Jaxal83/parkingSensor/Spring 2020/Hardware Design/Park-It-CDA fritzing.JPG

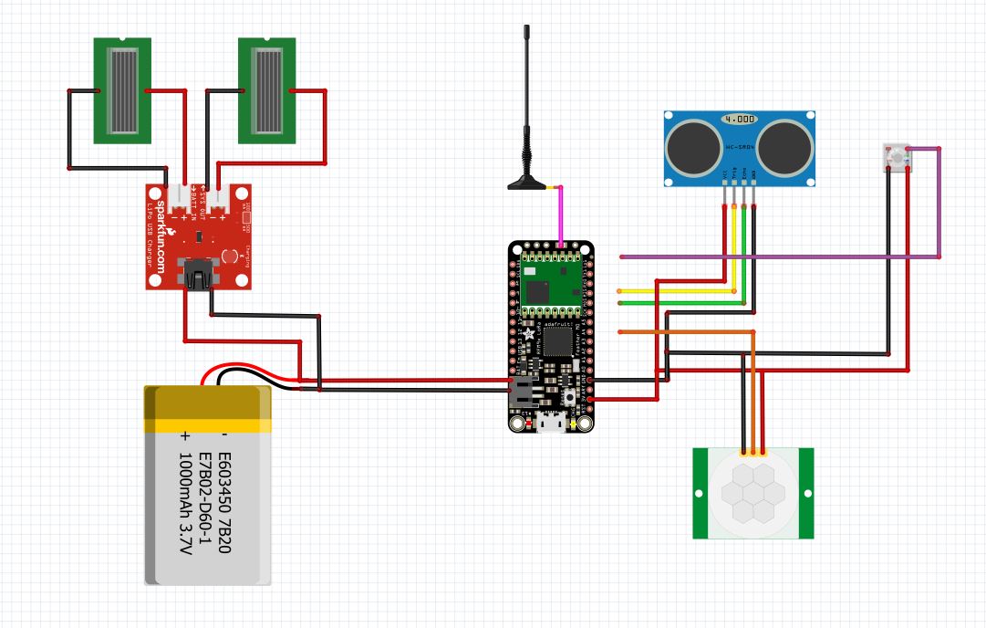
Spring 2020/Hardware Design/Park-It-CDA fritzing.JPG
