Jaxal83/parkingSensor/Spring 2020/Hardware Design/projects_batt_solar.jpg

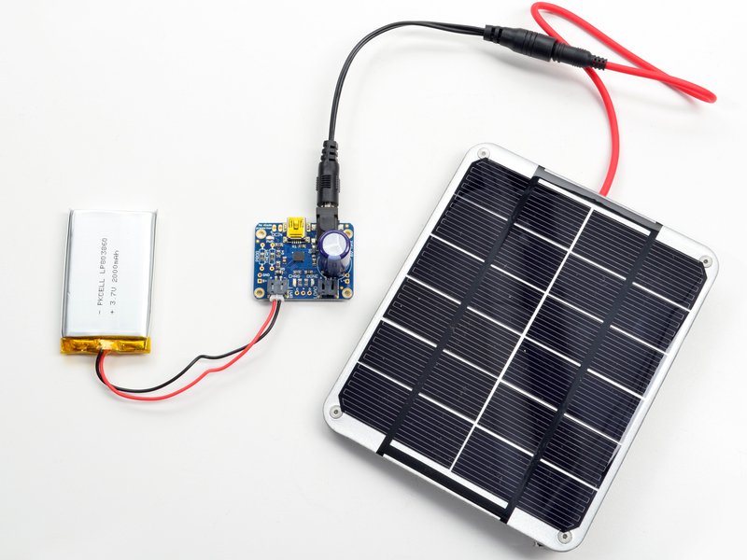
Spring 2020/Hardware Design/projects_batt_solar.jpg
