Jaxal83/parkingSensor/Spring 2020/Project Status Report 2-19.docx

# Project Status Report

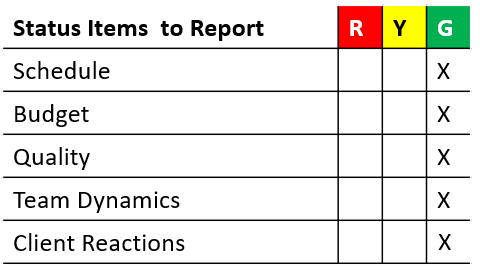
[picture p15: figure]

# Nikolai

Get the mesh network communication working on the Adafruit Feathers without requiring EEPROM.

First step was to find out how to obtain a unique identifier on the Feather M0’s.

There was the possibility of a MAC address on the Radio, LoRa serial number or the SAMD21 processor having an ID. Found a library that can extract this value and display it on serial output.

From here I hard coded the first byte in the radio sending test and assigned an ID of 1 or 2 to the two Feathers that I have for simplicity. Once the others come in, they will be assigned 3 – 7.

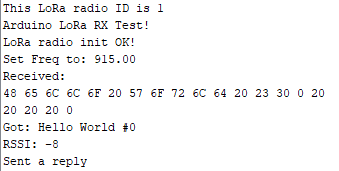
[picture p16: figure]
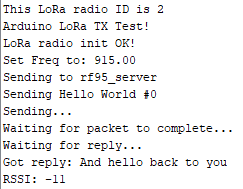
[picture p17: figure]

Next step is to have the Feathers go to sleep and then wake up on a timer to send a message.

This will be more difficult to debug since the serial port to the monitor gets disabled upon sleep and doesn’t get reestablished upon waking. I plan to use the built in LED to blink a number of times depending on whether it is sending or has received a message.

# Tyrel

# Zane

# Joel
