Jaxal83/parkingSensor/Client Meetings/Client meeting 4-9-20.docx

Date: 4/9/20

Start Time: 3:30 pm

End Time: 4:45 pm

Present: Nikolai, Zane, Joel, Dr Shovic, Tyrel, Dr Sheldon

Location: Innovation Den

Agenda: Follow up on the design report and changes to the project

Outcomes: John is going to provide 2 Yagi antennas for us to use

To Do: Zane and Nikolai are going to test out the antennas and see how far we get
