Jaxal83/parkingSensor/Team Meetings/3-23-20.docx

Date: 3/23/20

Start Time: 2:40 pm

End Time: 2:50 pm

Present: Nikolai, Tyrel

Location: Tyrel’s House

Agenda: Tyrel received the gateway but couldn’t turn it on. Asked in Discord whether any of us has a 12V 1 A power supply. Nikolai does and went to give it to him.

Outcomes: The power supply worked.

To Do: Tyrel is working on getting the broken power supply RMA’ed
