Jaxal83/parkingSensor/Team Meetings/3-6-20.docx

Date: 3/6/20

Start Time: 12:15 pm

End Time: 12:30 pm

Present: Nikolai, Joel

Location: Discord

Agenda: Joel reappeared

Outcomes: Have instructed Joel on what he will be doing. Nikolai will give him 2 Arduino Uno’s with LoRa radios attached. Joel will then need to use the send/receive program and update it to encrypt the messages sent between the units.

To Do: Joel – install Arduino IDE
