Jaxal83/parkingSensor/Team Meetings/4-16-20.docx

Date: 4/16/20

Start Time: 3:30 pm

End Time: 4:45 pm

Present: Nikolai, Tyrel, Zane, Joel, Dr Sheldon

Location: Zoom

Agenda: Update on what we’ve been doing.

Outcomes: Zane and Nikolai have been having difficulty with getting the range required on the antennas.

Joel needs to fix the encryption program.

Tyrel is going to give Nikolai the Dragino gateway and set it up to reach his MQTT server over the internet.

To Do: Email John to see what we can do about
