Jaxal83/parkingSensor/Team Meetings/4-23-20.docx

Date: 4/23/20

Start Time: 3:30 pm

End Time: 4:45 pm

Present: Nikolai, Tyrel, Zane, Joel, Dr Sheldon

Location: Zoom

Agenda: Final preparations before the expo

Outcomes: We need to come up with a plan B if we can’t get the range on the antennas working. Either Nikolai’s and Zane’s driveway will be the location of the demo.

To Do: Spend all weekend trying to get the antennas working

Prepare the Powerpoint presentation and present it next week in some practice runs with everyone
