Jaxal83/parkingSensor/Team Meetings/4-30-20.docx

Date: 4/30/20

Start Time: 11:30 am

End Time: 9:00 pm

Present: Nikolai, Tyrel, Zane, Joel, Dr Sheldon

Location: Zoom, Discord

Agenda: Combination of multiple meetings today. Continued refining and practicing the presentation. Presented to Dr Sheldon again at 3:30pm

Outcomes: We are getting better on timing and reducing it. 16:20 for first practice, 12:40 for second, 13:06 for third.

To Do: Tyrel and Zane are recording new demo videos to put in
