Jaxal83/parkingSensor/Fall 2019/meeting 9-24-19.docx

What lora chip will we use if any

What platform – Arduino uno, nano? All in one

Need to research this and get them ordered – try for thursday.

We’ll all need about 3-5 each for testing individually.

Sound

Atmega 32u4
