Jaxal83/parkingSensor/Fall 2019/9mo calendar.docx

| 9-Month timeline

By: Nikolai Tiong, Tyrel Parker, Zane Goodrick

Tasks | | -Design -Prototype -Testing -Network -Reporting -Data -Simulation | | Goal | | Finalized design by Mid October | | Jobs | | Nikolai- Tyrel- Zane-
2019 Sep | | Research and design proposals | | 2019 Oct | | Testing and building | | 2019 Nov | | Testing and building of final design
2019 Dec | | Finishing prototype | | 2020 Jan | | Building deployable units | | 2020 Feb | | Deploy units for data collection
2020 Mar | | Implement data into simulation | | 2020 Apr | | Finalizing expo marketing items | | 2020 May | | Expo
