Jaxal83/parkingSensor/Team Meetings/2-11-20.docx

Date: 2/11/20

Start Time: 3:30 pm

End Time: 4:45 pm

Present: Nikolai, Tyrel, Joel, Dr Sheldon, Dr Rinker

Location: Innovation Den

Agenda: Joel will give his presentation on the Wiki page and his progress so far.

Outcomes: The wiki still needs more work on it.

Joel needs to contact Dr Shovic on his own time to find out about the VNC requirements

To Do: Joel Keeps working on the wiki.

Keep working on the project
