Jaxal83/parkingSensor/Fall 2019/capstone use case.jpg

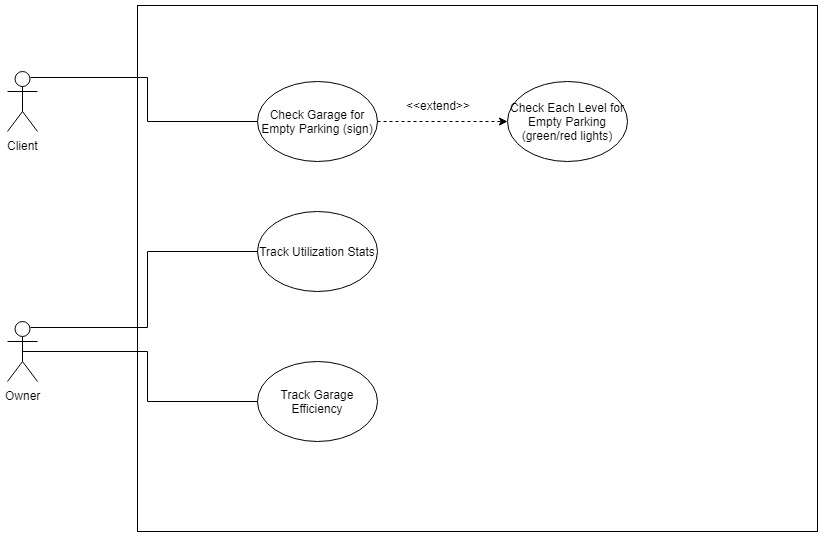
Fall 2019/capstone use case.jpg
