Jaxal83/parkingSensor/Spring 2020/database.png

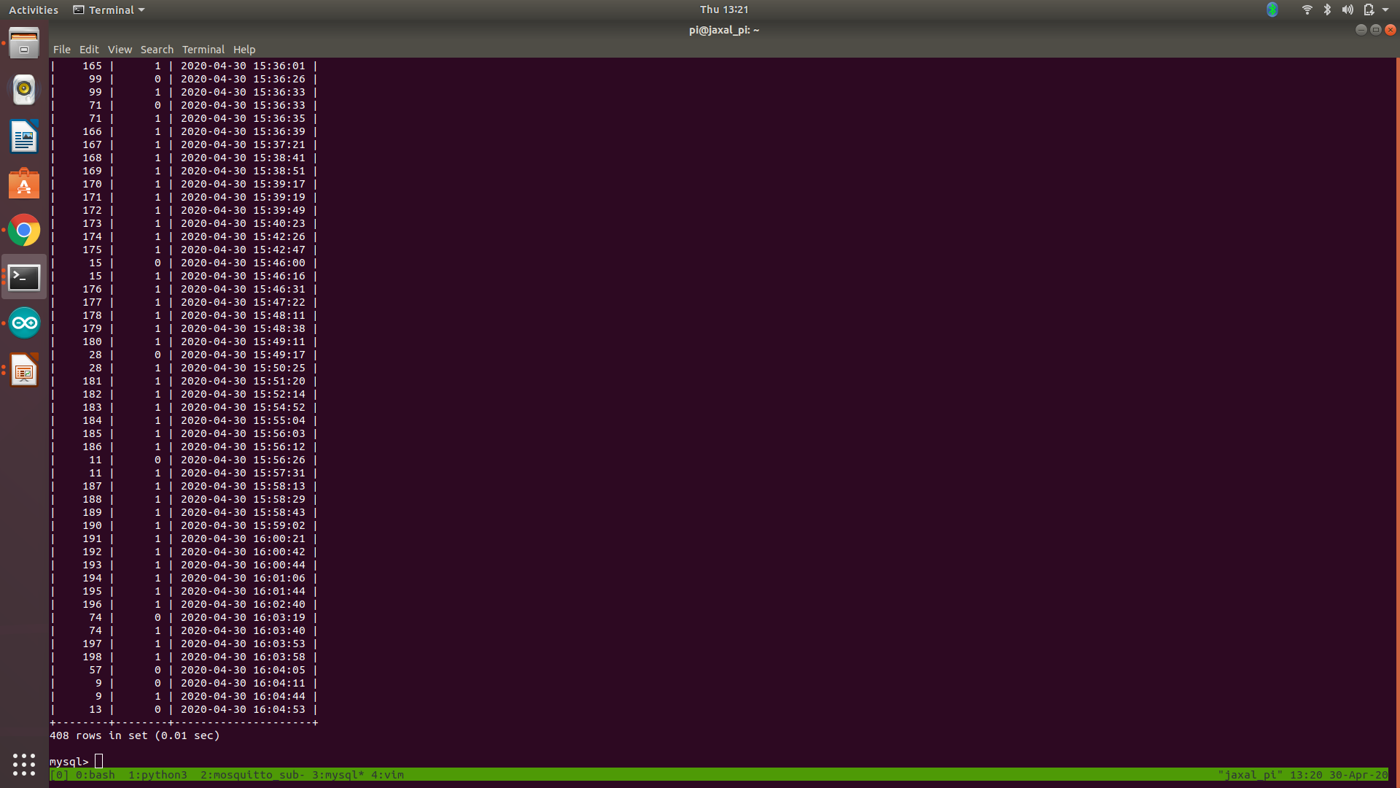
Spring 2020/database.png
