Jaxal83/parkingSensor/Spring 2020/google map of garage.png

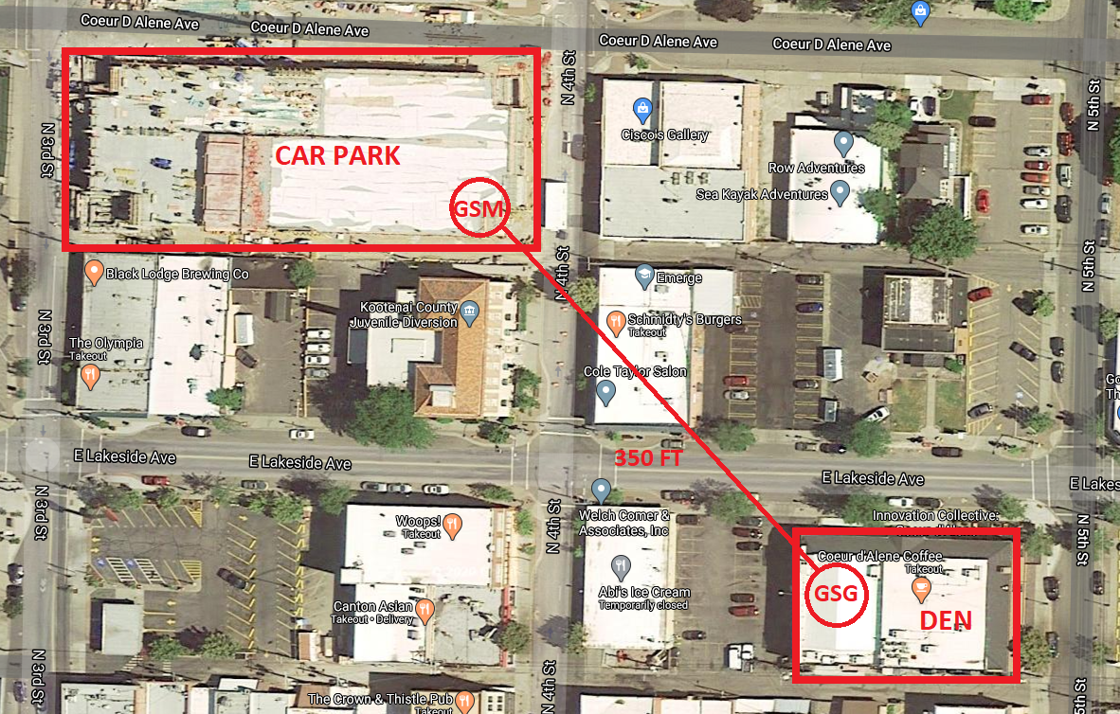
Spring 2020/google map of garage.png
