Jaxal83/parkingSensor/Spring 2020/Hardware Design/example solar arduino schematic.png

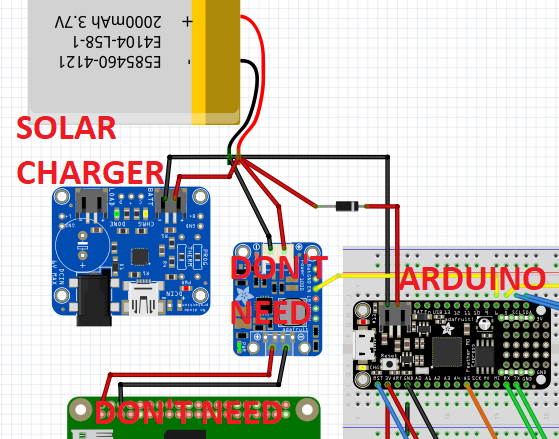
Spring 2020/Hardware Design/example solar arduino schematic.png
