Jaxal83/parkingSensor/Spring 2020/Hardware Design/final model front.PNG

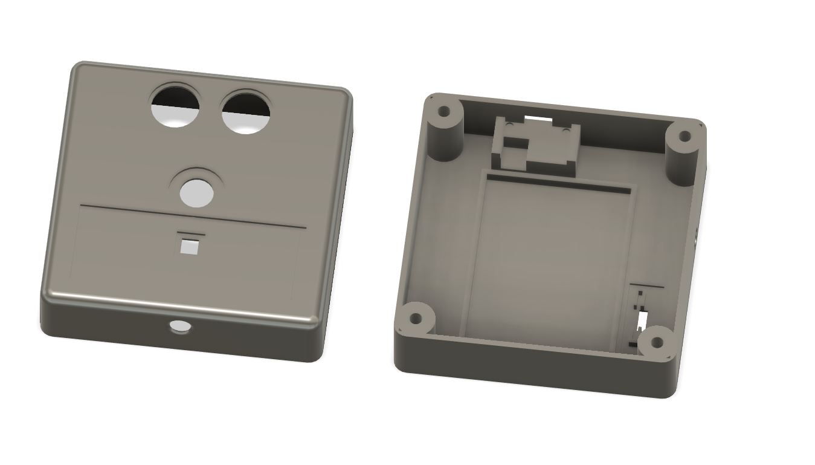
Spring 2020/Hardware Design/final model front.PNG
