Jaxal83/parkingSensor/Spring 2020/Hardware Design/Final Model.PNG

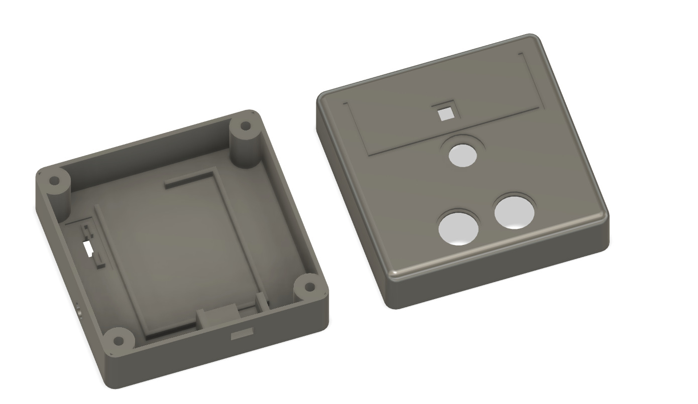
Spring 2020/Hardware Design/Final Model.PNG
