Jaxal83/parkingSensor/Spring 2020/Hardware Design/rough sketch.jpg

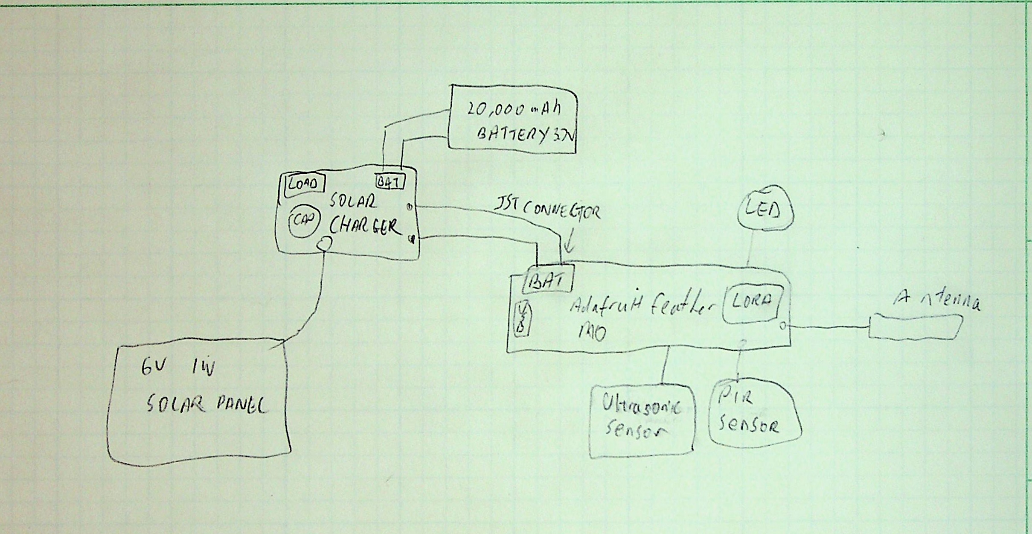
Spring 2020/Hardware Design/rough sketch.jpg
