Jaxal83/parkingSensor/Spring 2020/Possible Battery Purchases.xlsx

Item | Quantity | Price | Total | Notes | Link
Adafruit Feather M0 LoRa | 5 | $34.95 | $174.75 | The Arduino we will be using | https://www.adafruit.com/product/3178
6V 1W Solar Panel | 5 | $19.95 | $99.75 | For Charging the Battery | https://www.adafruit.com/product/3809
Solar Charger | 5 | $17.50 | $87.50 | For Charging the Battery | https://www.adafruit.com/product/390
3.8 mm/1.3mm to 5.5/2.1 cable | 5 | $1.50 | $7.50 | Connects Solar Panel to Solar Charger | https://www.adafruit.com/product/2788
DS3231 RTC | 5 | $13.95 | $69.75 | Clock Module to keep Arduinos in Sync | https://www.adafruit.com/product/3013
3.6V 20.1Ah Li ION Battery | 5 | $92.15 | $460.75 |  | https://www.batteryspace.com/li-ion-18650-battery-3-6v-20-1ah-72-36wh-7a-rate-6s-s-ncr18650b---un38-3-passed.aspx
LoRa Gateway | 1
 |  |  | $900.00
