Jaxal83/parkingSensor/Spring 2020/Master_Gantt.ods

Sheet: Gantt
 | predicted time(hrs) | time spent(hrs) |  | 08/26/19 |  |  |  |  |  |  | 10/14/19 |  |  |  |  |  |  |  | 12/09/19 |  |  |  | 01/06/20 |  |  |  |  |  |  | 02/24/20 |  |  |  |  |  |  |  |  | 05/01/20
Nikolai |  |  | weeks | 1 | 2 | 3 | 4 | 5 | 6 | 7 | 8 | 9 | 10 | 11 | 12 | 13 | 14 | 15 | 16 | 17 | 18 | 19 | 20 | 21 | 22 | 23 | 24 | 25 | 26 | 27 | 28 | 29 | 30 | 31 | 32 | 33 | 34 | 35 | 36 | 37 | 38 | 39 | 40 | 41 | 42 | 43 | 44 | 45
research and purchase dev board | 5 | 20
test range | 10 | 60
design and develop mesh network | 30 | 60
implement security | 10 | 0
testing | 15 | 10
peer review | 10 | 4
documentation | 10 | 150
totals | 90 | 304
Tyrel
research simulation products | 10 | 35
determine needed data | 2 | 2
design transmission payload | 5 | 5
design and implement database | 5 | 5
design simulation environment | 15 | 95
implement data into simulation | 10 | 15
testing | 15 | 15
peer review | 10 | 10
documentation | 10 | 60
totals | 82 | 242
Zane
research and purchase sensor options | 5 | 20
test sensor options | 10 | 28
calculate power usage | 5 | 2
research and purchase power solution | 2 | 1
design and build case | 20 | 77
installation | 2 | 5
testing | 15 | 26
peer review | 10 | 2
documentation | 10 | 80
totals | 79 | 241
Joel
wiki | 15 | 30
encryption | 15 | 30
testing | 10 | 15
documentation | 10 | 8
totals | 50 | 83
group totals (hrs) | 301 | 870
group totals ($) | $30,100.00 | $87,000.00
 | planned
 | current
 | completed
 | late

Sheet: Gantt_2
 | 08/26/19 |  |  |  |  |  |  | 10/14/19 |  |  |  |  |  |  |  | 12/09/19 |  |  |  | 01/06/20 |  |  |  |  |  |  | 02/24/20 |  |  |  |  |  |  |  |  | 05/01/20
 | 1 | 2 | 3 | 4 | 5 | 6 | 7 | 8 | 9 | 10 | 11 | 12 | 13 | 14 | 15 | 16 | 17 | 18 | 19 | 20 | 21 | 22 | 23 | 24 | 25 | 26 | 27 | 28 | 29 | 30 | 31 | 32 | 33 | 34 | 35 | 36
Documentation
Research and purchase products
Test LoRa range
Determine needed data
Test sensors
Calculate power usage, research and purchase power solution
Design and develop mesh network, simulation environment, and units
Installation
Testing
Prepare for expo
Wiki
Encryption

Sheet: Management_Summary
 | Total |  |  | Coding |  |  | Meetings |  |  | Systems Analysis
 | Budgeted | Actual | Deficit | Budgeted | Actual | Deficit | Budgeted | Actual | Deficit | Budgeted | Actual | Deficit
Nikolai | $11,700.00 | $31,400.00 | ($19,700.00) | $9,000.00 | $30,400.00 | ($21,400.00) | $1,000.00 | $1,000.00 | $0.00 | $1,700.00 | $0.00 | $1,700.00
Tyrel | $10,800.00 | $25,100.00 | ($14,300.00) | $8,200.00 | $24,200.00 | ($16,000.00) | $1,000.00 | $900.00 | $100.00 | $1,600.00 | $0.00 | $1,600.00
Zane | $10,500.00 | $25,100.00 | ($14,600.00) | $7,900.00 | $24,100.00 | ($16,200.00) | $1,000.00 | $1,000.00 | $0.00 | $1,600.00 | $0.00 | $1,600.00
Joel | $5,500.00 | $11,200.00 | ($5,700.00) | $5,000.00 | $8,300.00 | ($3,300.00) | $500.00 | $2,900.00 | ($2,400.00)
Total | $33,000.00 | $81,600.00 | ($48,600.00) | $25,100.00 | $78,700.00 | ($53,600.00) | $3,000.00 | $2,900.00 | $100.00 | $4,900.00 | $0.00 | $4,900.00

Sheet: Meetings
 | Date | Aug 29 | Sep 05 | Sep 12 | Sep 19 | Oct 03 | Oct 10 | Oct 17 | Oct 24 | Nov 05 | Nov 12 | Nov 21 | Nov 28 | Dec 05 | Dec 12
 | Purpose | Team Meeting | First Customer Meeting | Team Meeting | Second Customer Meeting | Team Meeting | Team Meeting | Team Meeting | Teem Meeting | PDR | Team Meeting
 | Hours | 1 | 1 | 1 | 1 | 1 | 1 | 1 | 1 | 1 | 1 | 1 | 1 | 1 | 1
Nikolai | 10 | ü | ü | ü | ü | ü | ü | ü | ü | ü | ü
Tyrel | 9 | ü | ü | ü | ü | ü | ü | ü | ü |  | ü
Zane | 10 | ü | ü | ü | ü | ü | ü | ü | ü | ü | ü
Joel
Total | 29 | 3 | 3 | 3 | 3 | 3 | 3 | 3 | 3 | 2 | 3 | 0 | 0 | 0 | 0
ü

Sheet: SA
 | Task | Predicted(hrs) | spent(hrs) | 1 | 2 | 3 | 4 | 5 | 6 | 7 | 8 | 9 | 10 | 11 | 12 | 13 | 14 | 15
Nikolai | Technical Specs | 5
 | Meeting Notes | 5
 | SRS | 5
 | SRS2 | 2
 | Subtotal | 17 | 0
Tyrel | Gantt | 5
 | Budget | 5
 | PDR | 3
 | PDR2 | 1
 | CDR2 | 1
 | Updated Budget and Gantt | 1
 | Subtotal | 16 | 0
Zane | Diagrams | 4
 | Contract | 2
 | Project Plan | 4
 | PDR Diagrams | 2
 | Concept Art | 3
 | Updated Project Plan | 1
 | Subtotal | 16 | 0
 | Total | 49 | 0

Sheet: Budget
Item | Description | QTY | Est Price | Est Totals | *Blue Font indicates an estimated price due to additional research needed on that product. -Figuring 7 sets of sensors.
Boards | Arduino Pro Mini 328 | 10 | 9.45 | $94.50
LORA | Adafruit RFM95W LoRa Radio Transceiver | 10 | 17.96 | $179.60
Headers | Female and Male Header Bundle | 1 | 30 | $30.00
Antenna | 900 Mhz Antenna Kit for LoRa w/connector | 10 | 13.5 | $135.00
3D Printing Materials | White 3D printer filament | 3 | 19.99 | $59.97
Batteries | TBD | 7 | 20 | $140.00
Sensors | TBD | 7 | 20 | $140.00
Den Receiver | TBD | 1 | 100 | $100.00
Adhesive/ Mounting | TBD | 5 | 10 | $50.00
Paint | TBD | 3 | 5 | $15.00
 |  |  | Subtotal | $944.07
 |  |  | Goal | $1,500.00
 |  |  | Difference | $555.93
Item | Actual Description | QTY | Actual Price | Actual Totals
Boards | Arduino MKR 1310 | 2 | 42 | $84.00
LORA | Adafruit RFM95W LoRa Radio Transceiver | 3 | 19 | $57.00
Boards | Adafruit Feather M0 with LoRa | 5 | 34.95 | $174.75
Antenna | 4 PCS 915 Mhz LoRa Antenna | 2 | 10.99 | $21.98
Antenna connector | 10 PCS pack | 1 | 6.49 | $6.49
3D Printing Materials | Overture PLA Filament | 2 | 26.99 | $53.98
Batteries | 3.7v 2500mAh Rechargeable Lipo Battery | 5 | 15.09 | $75.45
Sensors | 5pcs Ultrasonic Distance Sensor | 1 | 14.13 | $14.13
Sensors | 5pcs PIR Motion Sensor | 1 | 13.99 | $13.99
Den Receiver | Dragino LG02 Gateway | 1 | 110.99 | $110.99
Adhesive/ Mounting | TBD |  |  | $0.00
Paint | TBD |  |  | $0.00
RTC | Adafruit DS3231 Precision RTC | 5 | 19.95 | $99.75
Coin Battery | 4 PCS Energizer CR 1220 3v Lithium Battery | 2 | 3.75 | $7.50
 |  |  | Subtotal | $612.76
 |  |  | Goal | $1,500.00
 |  |  | Difference | $887.24
