Jaxal83/parkingSensor/Fall 2019/Master_Gantt.ods

Sheet: Gantt
 | predicted time(hrs) | time spent(hrs) |  | 08/26/19 |  |  |  |  |  |  | 10/14/19 |  |  |  |  |  |  |  | 12/09/19 |  |  |  | 01/06/20 |  |  |  |  |  |  | 02/24/20 |  |  |  |  |  |  |  |  | 05/01/20
Nikolai |  |  | weeks | 1 | 2 | 3 | 4 | 5 | 6 | 7 | 8 | 9 | 10 | 11 | 12 | 13 | 14 | 15 | 16 | 17 | 18 | 19 | 20 | 21 | 22 | 23 | 24 | 25 | 26 | 27 | 28 | 29 | 30 | 31 | 32 | 33 | 34 | 35 | 36 | 37 | 38 | 39 | 40 | 41 | 42 | 43 | 44 | 45
research and purchase dev board | 5 | 5
test range | 10 | 6
design and develop mesh network | 30 | 3
implement security | 10
testing | 15 | 2
peer review | 10
documentation | 10 | 15
totals | 90 | 16
Tyrel
research simulation products | 10
determine needed data | 2
design transmission payload | 5
design and implement database | 5
design simulation environment | 15
implement data into simulation | 10
testing | 15
peer review | 10
documentation | 10
totals | 82 | 0
Zane
research and purchase sensor options | 5
test sensor options | 10
calculate power usage | 5
research and purchase power solution | 2
design and build case | 20
installation | 2
testing | 15
peer review | 10
documentation | 10
totals | 79 | 0
group totals (hrs) | 251 | 16
group totals ($) | $25,100.00 | $1,600.00
 | planned
 | current
 | completed
 | late

Sheet: Gantt_2
 | 08/26/19 |  |  |  |  |  |  | 10/14/19 |  |  |  |  |  |  |  | 12/09/19 |  |  |  | 01/06/20 |  |  |  |  |  |  | 02/24/20 |  |  |  |  |  |  |  |  | 05/01/20
 | 1 | 2 | 3 | 4 | 5 | 6 | 7 | 8 | 9 | 10 | 11 | 12 | 13 | 14 | 15 | 16 | 17 | 18 | 19 | 20 | 21 | 22 | 23 | 24 | 25 | 26 | 27 | 28 | 29 | 30 | 31 | 32 | 33 | 34 | 35 | 36
Documentation
Research and purchase products
Test LoRa range
Determine needed data
Test sensors
Calculate power usage, research and purchase power solution
Design and develop mesh network, simulation environment, and units
Installation
Testing
Prepare for expo

Sheet: Management_Summary
 | Total |  |  | Coding |  |  | Meetings |  |  | Systems Analysis
 | Budgeted | Actual | Deficit | Budgeted | Actual | Deficit | Budgeted | Actual | Deficit | Budgeted | Actual | Deficit
Nikolai | $11,700.00 | $2,600.00 | $9,100.00 | $9,000.00 | $1,600.00 | $7,400.00 | $1,000.00 | $1,000.00 | $0.00 | $1,700.00 | $0.00 | $1,700.00
Tyrel | $10,800.00 | $900.00 | $9,900.00 | $8,200.00 | $0.00 | $8,200.00 | $1,000.00 | $900.00 | $100.00 | $1,600.00 | $0.00 | $1,600.00
Zane | $10,500.00 | $1,000.00 | $9,500.00 | $7,900.00 | $0.00 | $7,900.00 | $1,000.00 | $1,000.00 | $0.00 | $1,600.00 | $0.00 | $1,600.00
Total | $33,000.00 | $4,500.00 | $28,500.00 | $25,100.00 | $1,600.00 | $23,500.00 | $3,000.00 | $2,900.00 | $100.00 | $4,900.00 | $0.00 | $4,900.00

Sheet: Meetings
 | Date | Aug 29 | Sep 05 | Sep 12 | Sep 19 | Oct 03 | Oct 10 | Oct 17 | Oct 24 | Nov 05 | Nov 12 | Nov 21 | Nov 28 | Dec 05 | Dec 12
 | Purpose | Team Meeting | First Customer Meeting | Team Meeting | Second Customer Meeting | Team Meeting | Team Meeting | Team Meeting | Teem Meeting | PDR | Team Meeting
 | Hours | 1 | 1 | 1 | 1 | 1 | 1 | 1 | 1 | 1 | 1 | 1 | 1 | 1 | 1
Nikolai | 10 | ü | ü | ü | ü | ü | ü | ü | ü | ü | ü
Tyrel | 9 | ü | ü | ü | ü | ü | ü | ü | ü |  | ü
Zane | 10 | ü | ü | ü | ü | ü | ü | ü | ü | ü | ü
Total | 29 | 3 | 3 | 3 | 3 | 3 | 3 | 3 | 3 | 2 | 3 | 0 | 0 | 0 | 0
ü

Sheet: SA
 | Task | Predicted(hrs) | spent(hrs) | 1 | 2 | 3 | 4 | 5 | 6 | 7 | 8 | 9 | 10 | 11 | 12 | 13 | 14 | 15
Nikolai | Technical Specs | 5 | 6
 | Meeting Notes | 5 | 6
 | SRS | 5 | 6
 | SRS2 | 2 | 1
 | PDR - LoRa Portion |  | 2
 | CDR - Battery, LoRa Milestones |  | 1
 | Subtotal | 17 | 22
Tyrel | Gantt | 5
 | Budget | 5
 | PDR | 3
 | PDR2 | 1
 | CDR2 | 1
 | Updated Budget and Gantt | 1
 | Subtotal | 16 | 0
Zane | Diagrams | 4
 | Contract | 2
 | Project Plan | 4
 | PDR Diagrams | 2
 | Concept Art | 3
 | Updated Project Plan | 1
 | Subtotal | 16 | 0
 | Total | 49 | 22

Sheet: Budget
Item | Description | QTY | Est Price | Est Totals | *Blue Font indicates an estimated price due to additional research needed on that product. -Figuring 7 sets of sensors.
Boards | Arduino Pro Mini 328 | 10 | 9.45 | $94.50
LORA | Adafruit RFM95W LoRa Radio Transceiver | 10 | 17.96 | $179.60
Headers | Female and Male Header Bundle | 1 | 30 | $30.00
Antenna | 900 Mhz Antenna Kit for LoRa w/connector | 10 | 13.5 | $135.00
3D Printing Materials | White 3D printer filament | 3 | 19.99 | $59.97
Batteries | TBD | 7 | 20 | $140.00
Sensors | TBD | 7 | 20 | $140.00
Den Receiver | TBD | 1 | 100 | $100.00
Adhesive/ Mounting | TBD | 5 | 10 | $50.00
Paint | TBD | 3 | 5 | $15.00
 |  |  | Subtotal | $944.07
 |  |  | Goal | $1,500.00
 |  |  | Difference | $555.93
Item | Actual Description | QTY | Actual Price | Actual Totals
Boards | Arduino MKR 1310 | 2 | 42 | $84.00
LORA | Adafruit RFM95W LoRa Radio Transceiver | 3 | 19 | $57.00
Headers |  |  |  | $0.00
Antenna | 900 Mhz Antenna Kit for LoRa w/connector | 2 | 10.99 | $21.98
3D Printing Materials | White 3D printer filament |  |  | $0.00
Batteries | TBD |  |  | $0.00
Sensors | TBD |  |  | $0.00
Den Receiver | TBD |  |  | $0.00
Adhesive/ Mounting | TBD |  |  | $0.00
Paint | TBD
 |  |  | Subtotal | $162.98
 |  |  | Goal | $1,500.00
 |  |  | Difference | $1,337.02
