Jaxal83/parkingSensor/Fall 2019/battery usage.xlsx

Days Per Year | 365
Frequency per Hour | 2
Hours Per day | 14
Days Per Month | 30
Frequency per Hour (LED) | 3600
Available Capacity (mAh) | 8800 | 13728 | 17600
 | Current Drawn (mA) | Duration (s) | mAh per Day | mAh per Month | mAh per Year
Transmitting | 50 | 1 | 0.39 | 11.67 | 141.94
Receiving | 20 | 30 | 4.67 | 140.00 | 1703.33
PIR | 2 | 10 | 0.16 | 4.67 | 56.78
Ultrasonic | 6 | 10 | 0.47 | 14.00 | 170.33
LED | 20 | 0.05 | 2.00 | 60.00 | 730.00
Arduino (Blink LED) | 30 | 0.05 | 3.00 | 90.00 | 1095.00
Arduino (LoRa, Receiving) | 30 | 30 | 7.00 | 210.00 | 2555.00
 |  |  |  | Total Used (mAh) | 6452.39
 |  |  |  | Remaining (mAh) | 2347.61 | 7275.61 | 11147.61
 |  |  |  | Idle Draw (mA) | 0.27 | 0.83 | 1.27
