Jaxal83/parkingSensor/Spring 2020/Hardware Design/GSU Assembled.png

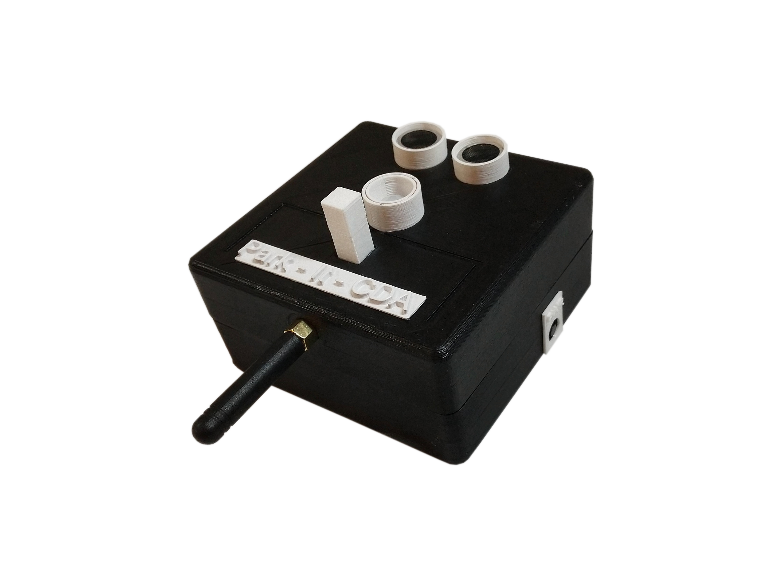
Spring 2020/Hardware Design/GSU Assembled.png
