Jaxal83/parkingSensor/Spring 2020/testing webpage2.png

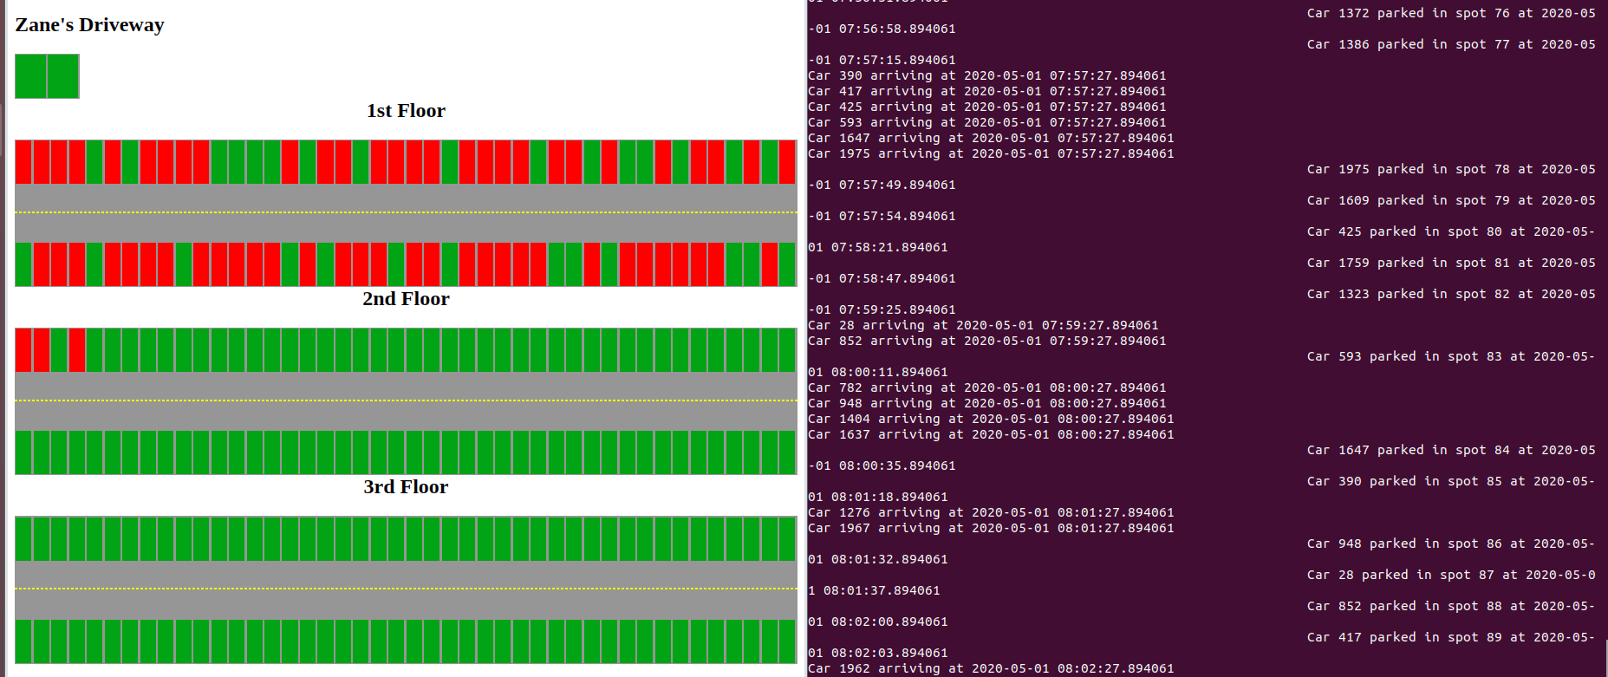
Spring 2020/testing webpage2.png
