Jaxal83/parkingSensor/Spring 2020/testing webpage 3.png

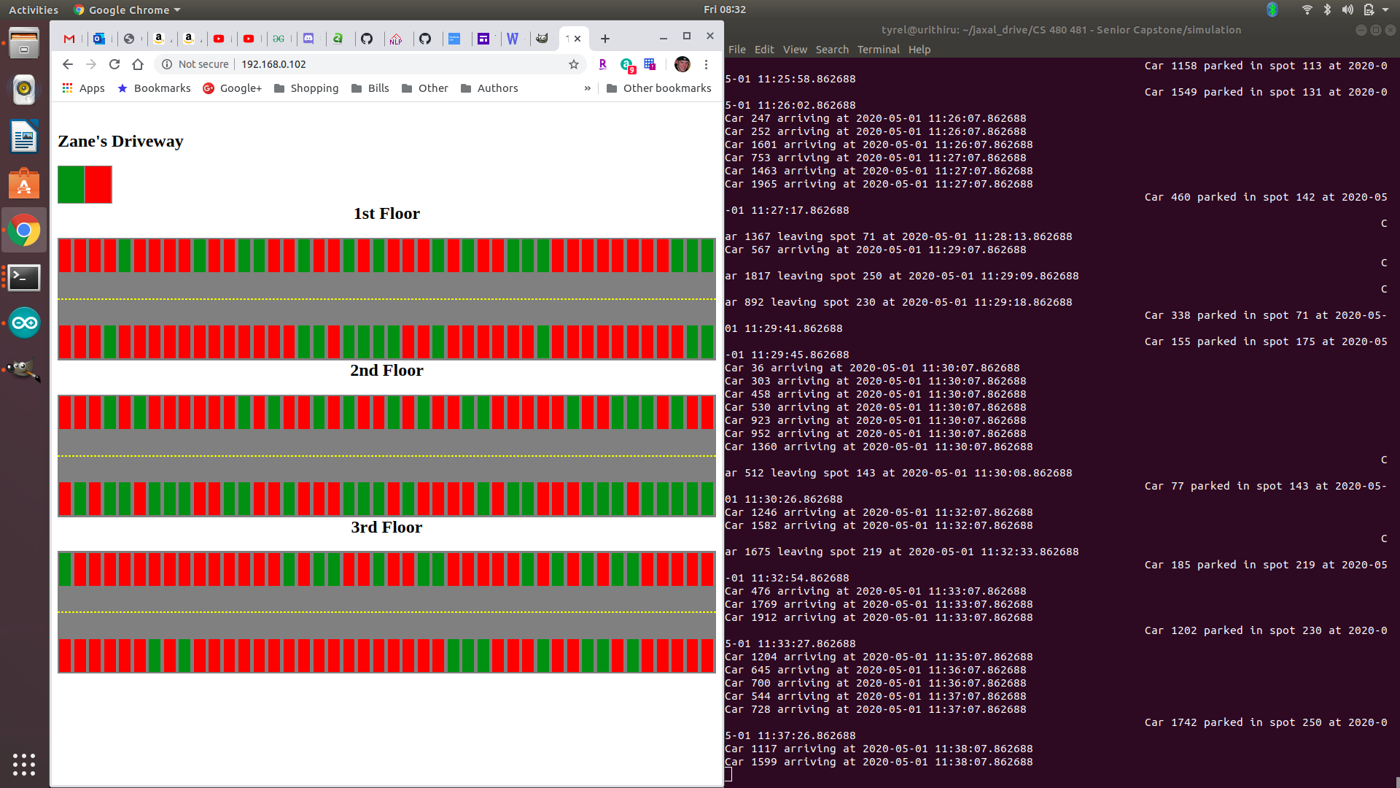
Spring 2020/testing webpage 3.png
