Jaxal83/parkingSensor/Spring 2020/testing webpage.png

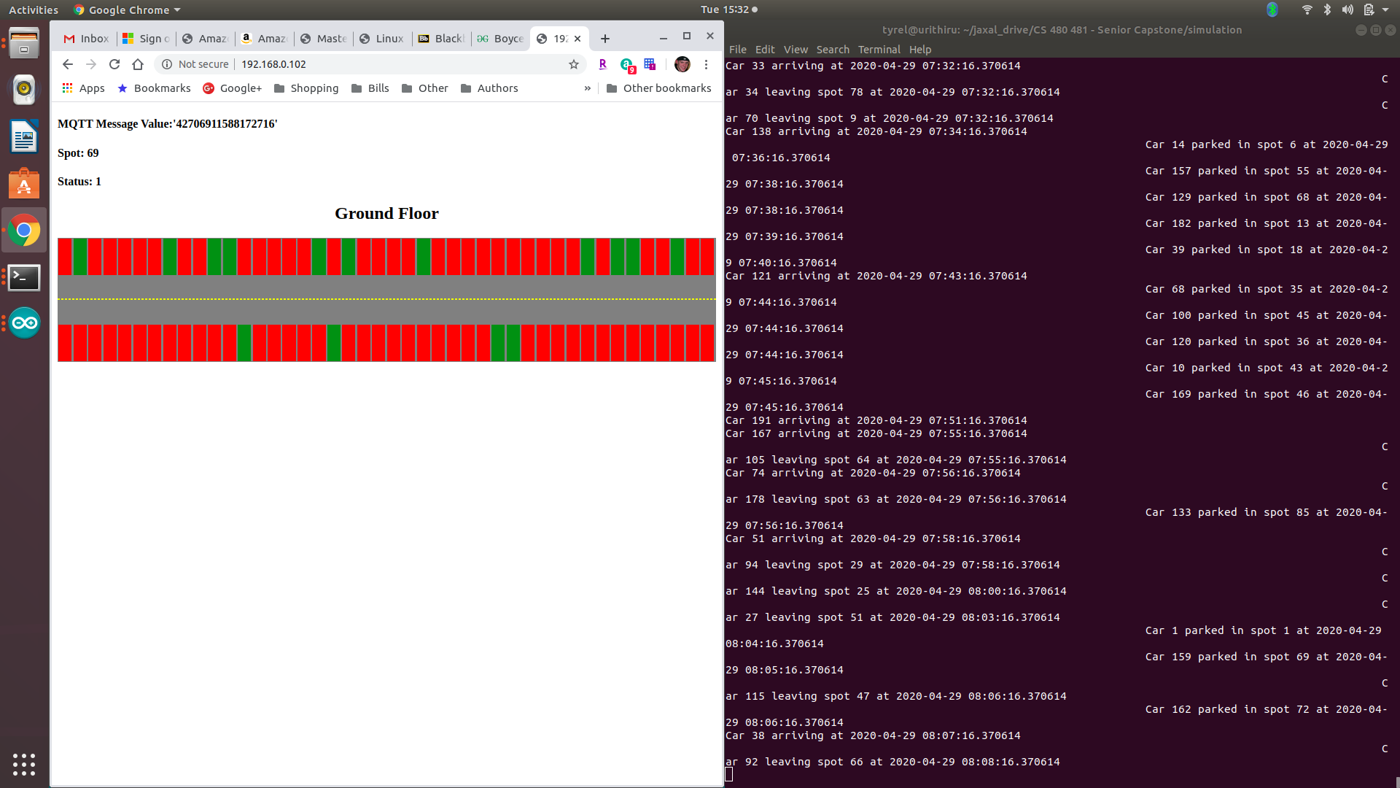
Spring 2020/testing webpage.png
