Jaxal83/parkingSensor/Fall 2019/PIC context diagram level 0.pdf

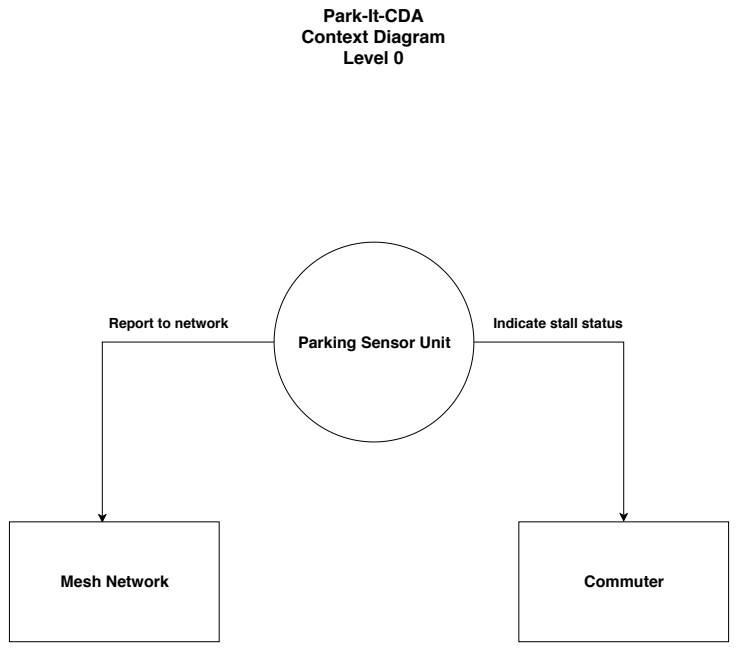
[picture p39: page 1]
Mesh Network; Commuter; Report to network; Indicate stall status

Park-It-CDA
Context Diagram
Level 0

Parking Sensor Unit
