Jaxal83/parkingSensor/Fall 2019/PIC context diagram level 1.pdf

Commuter | LED Indicator

## Park-It-CDA

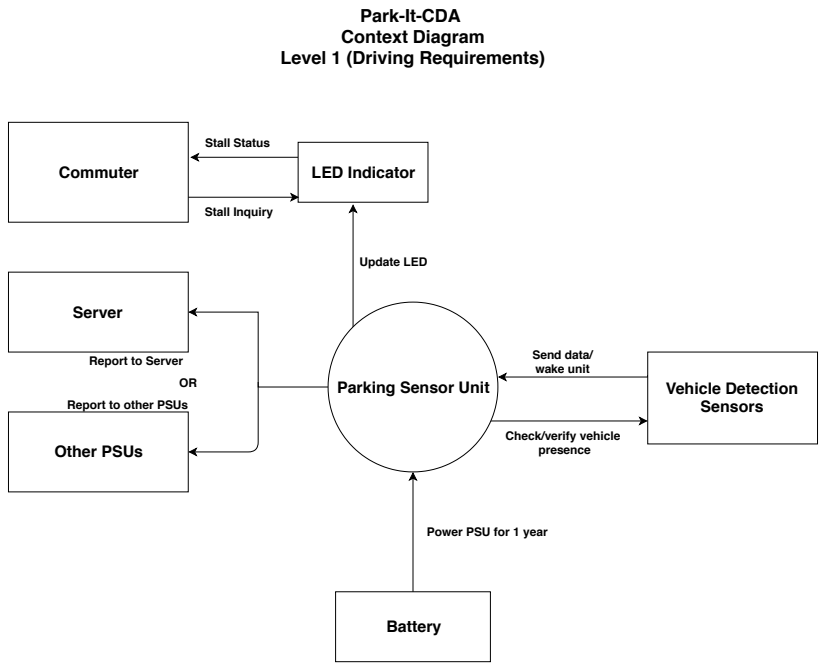
[picture p40: page 1]
Server; Other PSUs; Stall Status; Stall Inquiry; Update LED; Vehicle Detection Sensors; Send data/ wake unit; Battery; Context Diagram

Level 1 (Driving Requirements)

Report to Server

Parking Sensor Unit

Report to other PSUs

Check/verify vehicle
presence

Power PSU for 1 year
