Jaxal83/parkingSensor/Fall 2019/PIC context diagram level 2.pdf

## Park-It-CDA Context Diagram

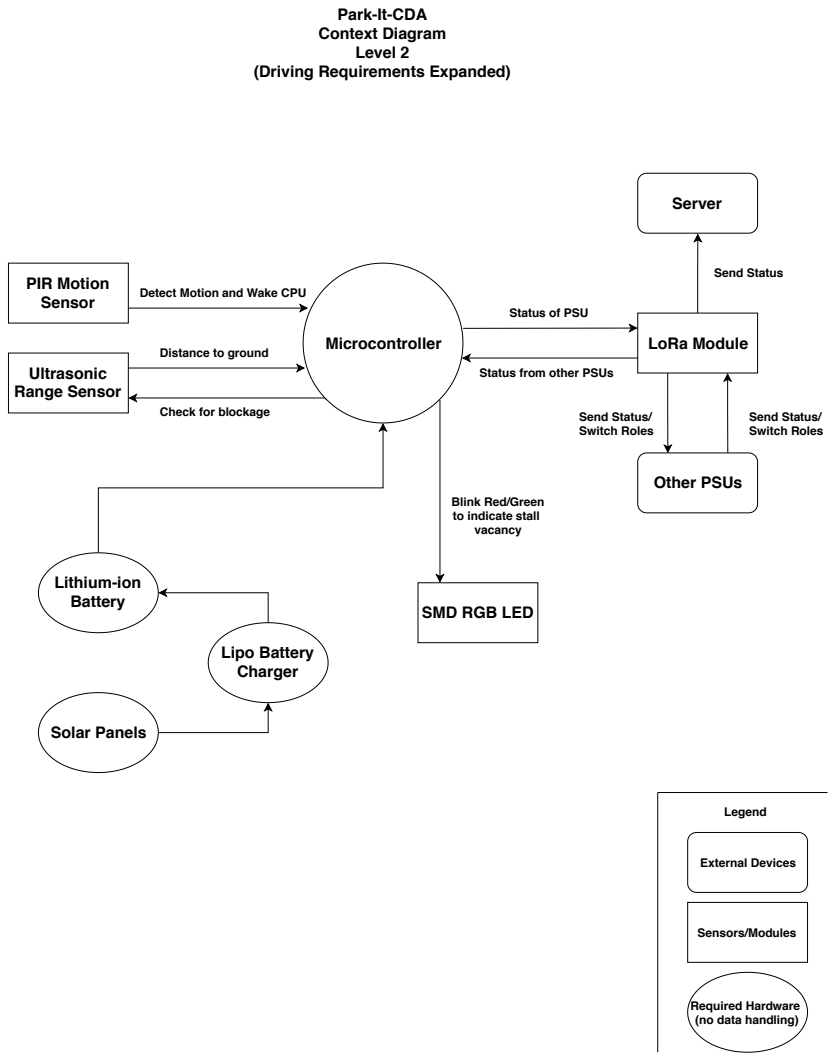
[picture p41: page 1]
Microcontroller; PIR Motion Sensor; Ultrasonic Range Sensor; Lithium-ion Battery; Solar Panels; LoRa Module; Send Status; Send Status/ Switch Roles; Lipo Battery Charger; Level 2; Server; Other PSUs; External Devices; Sensors/Modules; Legend

(Driving Requirements Expanded)

Detect Motion and Wake CPU

Status of PSU

Distance to ground

Status from other PSUs

Check for blockage

Blink Red/Green
to indicate stall
vacancy

SMD RGB LED

Required Hardware
(no data handling)
