Jaxal83/parkingSensor/Fall 2019/Parking Sensor Context Diagram.pdf

# Parking Sensor (placeholder name)

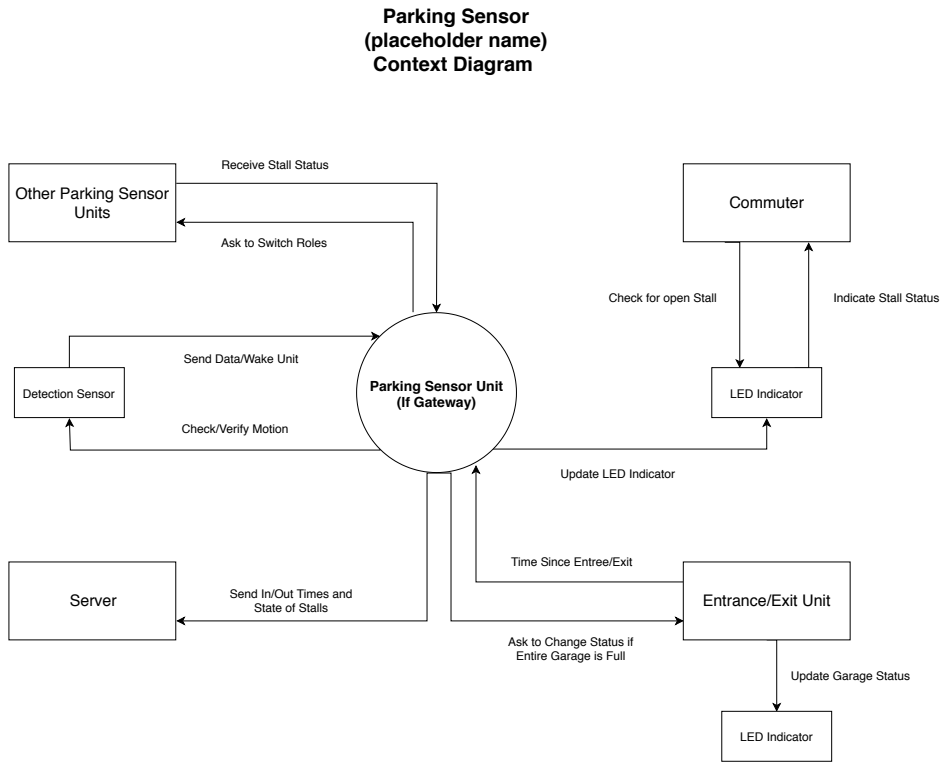
[picture p42: page 1]
Units; Server; Entrance/Exit Unit; Detection Sensor; LED Indicator; Check for open Stall; Indicate Stall Status; Context Diagram

Receive Stall Status

Commuter Other Parking Sensor

Ask to Switch Roles

Send Data/Wake Unit

Parking Sensor Unit
(If Gateway)

Check/Verify Motion

Update LED Indicator

Time Since Entree/Exit

Send In/Out Times and
State of Stalls

Ask to Change Status if
Entire Garage is Full

Update Garage Status
