Jaxal83/parkingSensor/(commit log)

2019-09-10 documents
    Rough Calendar
    Use Case Diagram
2019-11-16 Add files via upload
    Updates to Budget, Schedule, and CDR
    [Master_Gantt.ods]
2020-02-04 Add files via upload
    Added my project learning for sensors, led, enclosure. added desriptions for each under key features. added experimental design and data collection for these and a manufacturing plan. Will add fritzing diagram next
2020-04-29 Add files via upload
    Previous bugs debugged
    [duhCrypto.cpp, serverCryp.ino]
2020-04-29 Add files via upload
    Bugs debugged
    [clientCryp.ino]
2020-04-30 changed a couple of out of sync animations
2020-05-10 more docs
    [Possible Battery Purchases.xlsx, battery usage.xlsx, feather inventory.xlsx, presentation times.xlsx]
2020-05-13 Updated design report, portfolio, added client and team meeting documents, rearranged files
    [Master_Gantt.ods, Possible Battery Purchases.xlsx, battery usage.xlsx, feather inventory.xlsx, presentation times.xlsx]
2020-05-15 The award-winning powerpoint we presented at Expo
2020-05-16 Tyrel project portfolio update
2020-05-16 Final gantt
    [Master_Gantt.ods]
